mplattu/happiness-wireless/doc/aliexpress_airlgee_box.jpeg

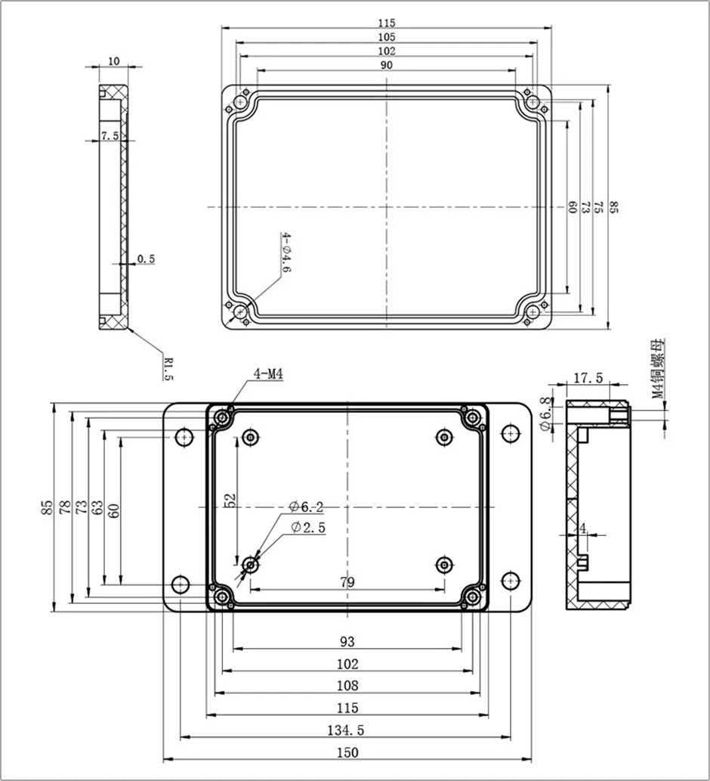
doc/aliexpress_airlgee_box.jpeg
