mplattu/happiness-wireless/src/happiness-wireless.cpp

#include <SPI.h>
#include <SD.h>
#include <TinyGPSPlus.h>
#include <SoftwareSerial.h>

#include "../include/constants.cpp"
#include "../include/beep.cpp"
#include "../include/wifi.cpp"

// 3 minutes (3 * 60 * 1000)
#define LOCATION_OUTDATED_MILLIS 180000

#define IGNORE_SATELLITES_WARNING

TinyGPSPlus gps;
SoftwareSerial gps_serial(PIN_GPS_RX, PIN_GPS_TX);

bool buttonPressedGreen;
bool buttonPressedRed;

void IRAM_ATTR interruptHandlerButtonGreen () {
    buttonPressedGreen = true;
}

void IRAM_ATTR interruptHandlerButtonRed () {
    buttonPressedRed = true;
}

bool buttonWifiPressed() {
    if (analogRead(PIN_WIFI_BUTTON) > 500) {
        return true;
    }

    return false;
}

void appendDataFile(char * action) {
    File f = SD.open(FILENAME_DATA, FILE_WRITE);
    if (f) {
        f.print("{\"device\":\"");
        f.print(WiFi.macAddress());
        f.print("\",\"action\":\"");
        f.print(action);
        f.println("\"}");
        f.close();
    }
    else {
        Serial.println("Could not open SD for writing");
    }
}

void appendDataFile(float latitude, float longitude, float altitude, float speed, int satellites, char * datetime, unsigned long locationUpdatedTime, char * action) {
    File f = SD.open(FILENAME_DATA, FILE_WRITE);
    if (f) {
        f.print("{\"device\":\"");
        f.print(WiFi.macAddress());
        f.print("\",\"latitude\":");
        f.print(latitude, 7);
        f.print(",\"longitude\":");
        f.print(longitude, 7);
        f.print(",\"altitude\":");
        f.print(altitude, 1);
        f.print(",\"speed\":");
        f.print(speed, 1);
        f.print(",\"satellites\":");
        f.print(satellites);
        f.print(",\"timestamp\":\"");
        f.print(datetime);
        f.print("\",\"locationUpdated\":");
        f.print(locationUpdatedTime);
        f.print(",\"action\":\"");
        f.print(action);
        f.print("\"");
        f.println("}");
        f.close();
    }
    else {
        Serial.println("Could not open SD for writing");
    }
}

bool locationIsOutdated(uint32_t satellites, unsigned long locationUpdated) {
#ifndef IGNORE_SATELLITES_WARNING    
    if (satellites < 4) {
        char buffer[50];
        sprintf(buffer, "Location is outdated: only %d satellites", satellites);
        appendDataFile(buffer);
        Serial.println(buffer);
        return true;
    }
#endif

    unsigned long updatedMillisAgo = millis() - locationUpdated;
    if (updatedMillisAgo > LOCATION_OUTDATED_MILLIS) {
        char buffer[60];
        sprintf(buffer, "Location is outdated: too old GPS: %lu > %d", updatedMillisAgo, LOCATION_OUTDATED_MILLIS);
        appendDataFile(buffer);
        Serial.println(buffer);
        return true;
    }

    return false;
}

void setup() {
    Serial.begin(115200);
    Serial.println("Started");

    pinMode(PIN_BUZZER, OUTPUT);
    pinMode(PIN_WIRELESS_BUTTON_RED, INPUT_PULLUP);
    pinMode(PIN_WIRELESS_BUTTON_GREEN, INPUT_PULLUP);

    attachInterrupt(PIN_WIRELESS_BUTTON_RED, interruptHandlerButtonRed, FALLING);
    attachInterrupt(PIN_WIRELESS_BUTTON_GREEN, interruptHandlerButtonGreen, FALLING);

    if (!SD.begin(PIN_CS)) {
        signalBeepAndHalt(1, "Failed to initialise SD writer");
    }

    gps_serial.begin(9600);
    if (!gps_serial) {
        signalBeepAndHalt(2, "Failed to initialise GPS serial device");
    }

    String wifiMacString = WiFi.macAddress();
    appendDataFile((char *) "boot");
    appendDataFile((char *) wifiMacString.c_str());
    appendDataFile((char *) __DATE__);
    appendDataFile((char *) __TIME__);

    beep(BEEP_DELAY_SHORT, 3);
    Serial.println("Initialised");
}

unsigned long locationUpdated = LOCATION_OUTDATED_MILLIS;

float latitude = 0;
float longitude = 0;
float altitude = 0;
float speed = 0;
unsigned long satellites = 0;
char gpsDate[20] = "no-date";
char gpsTime[20] = "no-time";
char gpsDatetime[40] = "no-datetime";
char * animation = (char*) ".oOo";
byte animationPosition = 0;

void loop() {
    while (gps_serial.available() > 0) {
        gps.encode(gps_serial.read());
    }

    if (gps.location.isUpdated()) {
        latitude = gps.location.lat();
        longitude = gps.location.lng();
        locationUpdated = millis();
    }

    if (gps.altitude.isUpdated()) {
        altitude = gps.altitude.meters();
    }

    if (gps.speed.isUpdated()) {
        speed = gps.speed.kmph();
    }

    if (gps.satellites.isUpdated()) {
        satellites = gps.satellites.value();
    }

    if (gps.date.isUpdated()) {
        sprintf(gpsDate, "%04d-%02d-%02d", gps.date.year(), gps.date.month(), gps.date.day());
        sprintf(gpsDatetime, "%s %s", gpsDate, gpsTime);
    }

    if (gps.time.isUpdated()) {
        sprintf(gpsTime, "%02d:%02d:%02d", gps.time.hour(), gps.time.minute(), gps.time.second());
        sprintf(gpsDatetime, "%s %s", gpsDate, gpsTime);
    }


    if (buttonPressedRed) {
        Serial.println("RED");
        unsigned long locationUpdatedTime = millis() - locationUpdated;
        appendDataFile(latitude, longitude, altitude, speed, satellites, gpsDatetime, locationUpdatedTime, (char *) "red");
        
        if (locationIsOutdated(satellites, locationUpdated)) {
            signalBeepNoGPS();
        }
        else {
            beep(BEEP_DELAY_LONG, 1);
        }

        buttonPressedRed = false;
    }

    if (buttonPressedGreen) {
        Serial.println("GREEN");
        unsigned long locationUpdatedTime = millis() - locationUpdated;
        appendDataFile(latitude, longitude, altitude, speed, satellites, gpsDatetime, locationUpdatedTime, (char *) "green");
        
        if (locationIsOutdated(satellites, locationUpdated)) {
            signalBeepNoGPS();
        }
        else {
            beep(BEEP_DELAY_SHORT, 2);
        }

        buttonPressedGreen = false;
    }

    if (buttonWifiPressed()) {
        Serial.println("WIFI");
        appendDataFile((char *) "wifi");
        signalBeepWifi();

        wifiOnButton(WIFI_SSID, WIFI_PASS, LOG_SERVER_URL);

        signalBeepWifi();

        appendDataFile((char *) "data upload succeeded");
    }

    Serial.print(' ');
    Serial.print(animation[animationPosition]);
    Serial.print('\r');
    animationPosition++;
    if (animationPosition > 3) {
        animationPosition = 0;
    }
    delay(200);
}
