mplattu/happiness-wireless/include/constants.cpp

#ifndef CONSTANTS_CPP
#define CONSTANTS_CPP

#define PIN_BUZZER 15               // D8
#define PIN_WIRELESS_BUTTON_RED 0   // D3
#define PIN_WIRELESS_BUTTON_GREEN 2 // D4
#define PIN_CS 16                   // D0
#define PIN_GPS_RX 5                // D1
#define PIN_GPS_TX 4                // D2
#define PIN_WIFI_BUTTON A0          // A0 (analog)

#define FILENAME_DATA "data.log"
#define FILENAME_ERROR "error.log"

// VERSION is used for Otadrive updates
#define VERSION "0.0.3"

#endif
