mplattu/happiness-wireless/(commit log)

2024-01-01 Breadboard ordered
    [Lipo Rider Plus.brd, Lipo Rider Plus.sch, happiness-wireless.csv, happiness-wireless.kicad_pcb, happiness-wireless.kicad_sch]
2024-01-01 Fixed 3V3 and 5V Charge Connectors
    * Use 3V3 from microcontroller (can output 500 mA) instead of
    Seeed charge controller (only 250 mA)
    * Lower 3V3 output might have been problem for microSD writer
    * Fixed wirings to charge connector
    [happiness-wireless.kicad_pcb, happiness-wireless.kicad_sch]
2024-01-06 Fixed transistor Q1 package and type
    [happiness-wireless.kicad_pcb, happiness-wireless.kicad_sch]
2024-01-13 Moved GPS and adjusted some connections (ordered v2) * Moved GPS towards the micro SD reader to make the GPS breakout board to fit into the selected case * Rearranged some routes to make them shorter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
    [happiness-wireless.kicad_pcb, happiness-wireless.kicad_sch]
2024-02-10 Removed incorrect connection * Removed connection from SW1 to +5V causing +5V and +3.3V to be connected
    [happiness-wireless.kicad_pcb]
2024-04-11 Incomplete wifi version
    Failing with a lot of exception zeros
    [beep.cpp, constants.cpp, happiness-wireless.cpp, memory.cpp, wifi.cpp]
2024-04-11 Trying to avoid exception 0 with ESP8266WiFiMulti
    [happiness-wireless.cpp, wifi.cpp]
2024-04-11 Write boot message and device info to log file
2024-04-11 Improved debug messages * added animation which shows the main loop is running * show message when wifi button is detected
2024-04-11 Add device mac address to log entries * It was considered to be the most straightforward way to distinguish the log entries. * It would have been possible to add the log entries in the upload phase b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
2024-04-11 Added missing quotation mark
    [happiness-wireless.cpp]
2024-05-12 Changes created by new KiCad version
2024-05-19 Added brief instructions for programming the button receivers
2024-05-23 Ignore number of satellites warning
    It turned out that NEO-6M does not report number of satellites or
    TinyGPS++ does not receive them. Therefore the rule which ignored
    button events when there is less than six satellites had to be abandoned.
